AC1I/PCB-reflow-solder-heat-plate/Debug Adapter/Debug Adapter.kicad_pcb

## KiCad design Debug Adapter/Debug Adapter.kicad_pcb (2024-11-06)

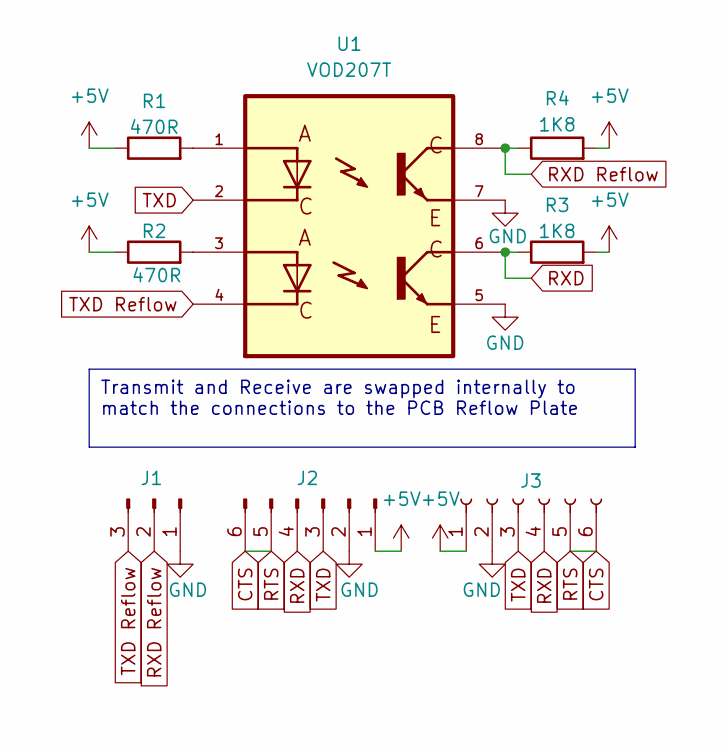
[picture p1: schematic Debug Adapter.kicad_sch]

Parts:
J1: Conn_01x03_Pin; PinHeader_1x03_P2.54mm_Vertical
J2: Conn_01x06_Pin; PinHeader_1x06_P2.54mm_Vertical
J3: Conn_01x06_Socket; PinHeader_1x06_P2.54mm_Horizontal
R1, R2: 470R; R_0402_1005Metric
R3, R4: 1K8; R_0402_1005Metric
U1: VOD207T; SOIC127P610X331-8N

Connections:
+5V: J2.1, J3.1, R1.1, R2.1, R3.2, R4.2
CTS: J2.5, J2.6, J3.5, J3.6
GND: J1.1, J2.2, J3.2, U1.5, U1.7
unnamed: R1.2, U1.1
unnamed: R2.2, U1.3
RXD: J2.4, J3.4, R3.1, U1.6
RXD Reflow: J1.2, R4.1, U1.8
TXD: J2.3, J3.3, U1.2
TXD Reflow: J1.3, U1.4

Notes on the sheet:
Transmit and Receive are swapped internally to match the connections to the PCB Reflow Plate

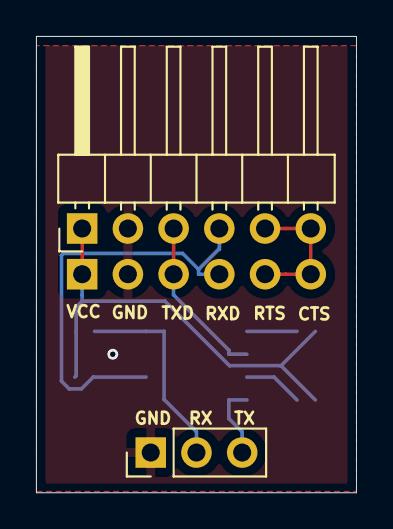
[picture p2: board Debug Adapter.kicad_pcb from above]

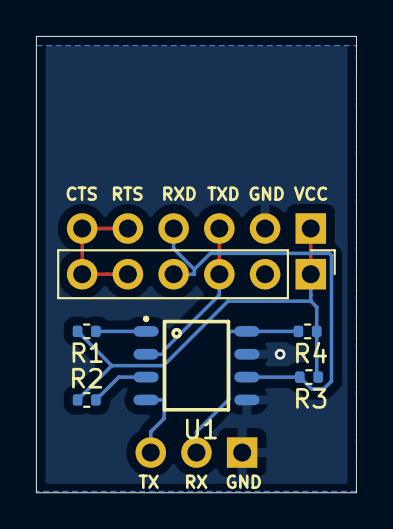
[picture p3: board Debug Adapter.kicad_pcb from below]

Board: 2 copper layers, 17.8 x 25.3 mm, 8 parts (6 on the bottom side), 9 nets.
