AC1I/PCB-reflow-solder-heat-plate/(commit log)

2024-09-28 Fix read of bed resistance from EEPROM
    [pcb_reflow_fw.ino]
2024-09-28 Manage maximum current hack
    We need to keep the current below 5A, or we blow the fuse. There is no current shunt, but there is a voltage input. Added hack (gimmick) to keep the current from exceeding 5 amps
2024-09-28 Opps
    Fix malconstructed comment.
    [pcb_reflow_fw.ino]
2024-09-29 Add user configurable PWM max duty cycle
    If the resistance of the PCB does not raise as expected when heated, or is to low when started the board will draw in excess of 5 amps and blow the fuse. Added a user configurable variable to limit the maximum PWM duty cycle thus constraining the current draw to acceptable levels.
2024-09-29 Constant current mode
    When the PWM maximum duty cycle constraint is 0 enable constant current mode.
2024-10-07 Improved Temperature calculations
    Utilized the temperature translation table from the LMT85 datasheet.
    Added serial debug interface.
    Create CSV file of temperature difference between temp1 and temp2 sensor.
    Added different led colors to indicate heating, cooldown, ready states.
    Added fork specific readme.
2024-10-11 Tweak Temperature Calibration
2024-10-17 Correct Debug Adapter
    [Debug Adapter-B_Cu.gbr, Debug Adapter-B_Mask.gbr, Debug Adapter-B_Paste.gbr, Debug Adapter-B_Silkscreen.gbr, Debug Adapter-Edge_Cuts.gbr, Debug Adapter-F_Cu.gbr, Debug Adapter-F_Mask.gbr, Debug Adapter-F_Paste.gbr]
2024-10-25 Update temperature estimate
2024-11-06 More temperature adjustments
    [Debug Adapter-B_Cu.gbr, Debug Adapter-B_Mask.gbr, Debug Adapter-B_Paste.gbr, Debug Adapter-B_Silkscreen.gbr, Debug Adapter-Edge_Cuts.gbr, Debug Adapter-F_Cu.gbr, Debug Adapter-F_Mask.gbr, Debug Adapter-F_Paste.gbr]
